fpgadeveloper/ethernetfmc/README.md

# ethernetfmc
Ethernet FMC documentation
==========================

Please read the documentation here:

https://ethernetfmc.com/documentation
