fpgadeveloper/ethernetfmc/docs/source/index.rst

.. Ethernet FMC documentation master file
   You can adapt this file completely to your liking, but it should at least
   contain the root `toctree` directive.

Ethernet FMC Documentation
==========================

Guides
------

* `Getting a license for the Xilinx Tri-mode Ethernet MAC <http://ethernetfmc.com/getting-a-license-for-the-xilinx-tri-mode-ethernet-mac/>`_
* `Using the 1.8V version with the ZedBoard <http://ethernetfmc.com/using-the-1-8v-version-with-the-zedboard/>`_
* `RGMII Interface Timing Considerations <http://ethernetfmc.com/rgmii-interface-timing-considerations/>`_
* `Using the Ethernet FMC without a processor <http://ethernetfmc.com/using-ethernet-fmc-without-a-processor/>`_

.. toctree::
   :maxdepth: 2
   :caption: Datasheet

   overview
   pin_configuration
   specifications
   detailed_description
   mechanical_info
   board_revisions

.. toctree::
   :maxdepth: 2
   :caption: User Guide

   getting_started
   programming_guide
   board_setup
   compatiblility
   eeprom_tool
   references
