fpgadeveloper/ethernetfmc/docs/source/references.rst

==========
References
==========

Board Files
===========

Ethernet FMC
------------

Rev-D
^^^^^

#. `Ethernet FMC Rev-D Schematics PDF <http://ethernetfmc.com/downloads/EthFMC_SCH_RevD-1.PDF>`_
#. `Ethernet FMC Rev-D Assembly Drawing PDF <http://ethernetfmc.com/downloads/EthFMC_ASSM_RevD.PDF>`_
#. `Ethernet FMC Rev-D 3D STEP model <http://ethernetfmc.com/downloads/EthernetFMC_RevD_3D.zip>`_

Rev-E
^^^^^

#. `Ethernet FMC Rev-E Schematics PDF <http://ethernetfmc.com/downloads/EthFMC_SCH_RevE-1.PDF>`_
#. `Ethernet FMC Rev-E Assembly Drawing PDF <http://ethernetfmc.com/downloads/EthFMC_ASSM_RevE.PDF>`_
#. `Ethernet FMC Rev-E 3D STEP model <http://ethernetfmc.com/downloads/EthernetFMC_RevE_3D.zip>`_

Rev-F
^^^^^

#. `Ethernet FMC Rev-F Schematics PDF <http://ethernetfmc.com/downloads/EthFMC_SCH_RevF-1.PDF>`_
#. `Ethernet FMC Rev-F Assembly Drawing PDF <http://ethernetfmc.com/downloads/EthFMC_ASSM_RevF.PDF>`_
#. `Ethernet FMC Rev-F 3D STEP model <http://ethernetfmc.com/downloads/EthernetFMC_RevF_3D.zip>`_

Robust Ethernet FMC
-------------------

Rev-C
^^^^^

#. `Robust Ethernet FMC Rev-C Schematics PDF <http://ethernetfmc.com/downloads/RobustEthFMC_SCH_RevC-1.PDF>`_
#. `Robust Ethernet FMC Rev-C Assembly Drawing PDF <http://ethernetfmc.com/downloads/RobustEthFMC_ASSM_RevC.PDF>`_
#. `Robust Ethernet FMC Rev-C 3D STEP model <http://ethernetfmc.com/downloads/RobustEthernetFMC_RevC_3D.zip>`_

Rev-D
^^^^^

#. `Robust Ethernet FMC Rev-D Schematics PDF <http://ethernetfmc.com/downloads/RobustEthFMC_SCH_RevD-1.PDF>`_
#. `Robust Ethernet FMC Rev-D Assembly Drawing PDF <http://ethernetfmc.com/downloads/RobustEthFMC_ASSM_RevD.PDF>`_
#. `Robust Ethernet FMC Rev-D 3D STEP model <http://ethernetfmc.com/downloads/RobustEthernetFMC_RevD_3D.zip>`_

Part Datasheets
===============

Use the links below to access the datasheets of the significant parts on the mezzanine card.

Ethernet FMC
------------

#. `Gigabit Ethernet PHY, 88E1510, Marvell <https://www.marvell.com/content/dam/marvell/en/public-collateral/transceivers/marvell-phys-transceivers-alaska-88e151x-datasheet-2018-02.pdf>`_ (public datasheet) [#f1]_
#. `Quad RJ45 connector with magnetics, JG0-0025NL, Pulse Electronics <http://productfinder.pulseeng.com/products/datasheets/J410.pdf>`_
#. `Quad RJ45 connector with magnetics, LPJG48851AFNL, Link-PP <http://www.link-pp.com/?product/201605079855.html>`_
#. `Crystal 25MHz, 8Z-25.000MAAJ-T, TXC <http://www.txccorp.com/download/products/quartz_crystals/2015TXC_8Z_16.pdf>`_
#. `Low pin count FMC connector, ASP-134604-01, Samtec <http://suddendocs.samtec.com/prints/asp-134604-01.pdf>`_
#. `Precision LVDS Oscillator 125MHz, DSC1123CI2-125.0000, Microchip <http://ww1.microchip.com/downloads/en/DeviceDoc/DSC1103-23-Low-Jitter-Precision-LVDS-Oscillator-DS20005745C.pdf>`_
#. `2Kbit serial I2C EEPROM, M24C02-FDW6TP, Microchip <https://www.st.com/en/memories/m24c02-f.html>`_

Robust Ethernet FMC
-------------------

#. `Gigabit Ethernet PHY, 88E1510, Marvell <https://www.marvell.com/content/dam/marvell/en/public-collateral/transceivers/marvell-phys-transceivers-alaska-88e151x-datasheet-2018-02.pdf>`_ (public datasheet) [#f1]_
#. `Quad RJ45 connector, RJE72-488-1451, Amphenol <https://cdn.amphenol-icc.com/media/wysiwyg/files/drawing/rje724881xxx.pdf>`_
#. `Ethernet magnetics, HX5020FNL, Pulse Electronics <https://productfinder.pulseeng.com/doc_type/WEB301/doc_num/HX5020FNL/doc_part/HX5020FNL.pdf>`_
#. `Crystal 25MHz, 8Z-25.000MAAJ-T, TXC <http://www.txccorp.com/download/products/quartz_crystals/2015TXC_8Z_16.pdf>`_
#. `Low pin count FMC connector, ASP-134604-01, Samtec <http://suddendocs.samtec.com/prints/asp-134604-01.pdf>`_
#. `Precision LVDS Oscillator 125MHz, DSC1123CI2-125.0000, Microchip <http://ww1.microchip.com/downloads/en/DeviceDoc/DSC1103-23-Low-Jitter-Precision-LVDS-Oscillator-DS20005745C.pdf>`_
#. `2Kbit serial I2C EEPROM, M24C02-FDW6TP, Microchip <https://www.st.com/en/memories/m24c02-f.html>`_

Footnotes
---------

.. [#f1] Marvell has a more detailed datasheet that can be obtained by signing an NDA
         with them. To have an NDA setup, please contact your Marvell representative.
