fpgadeveloper/ethernetfmc/docs/source/images/robust-ethernet-fmc-angle.jpg

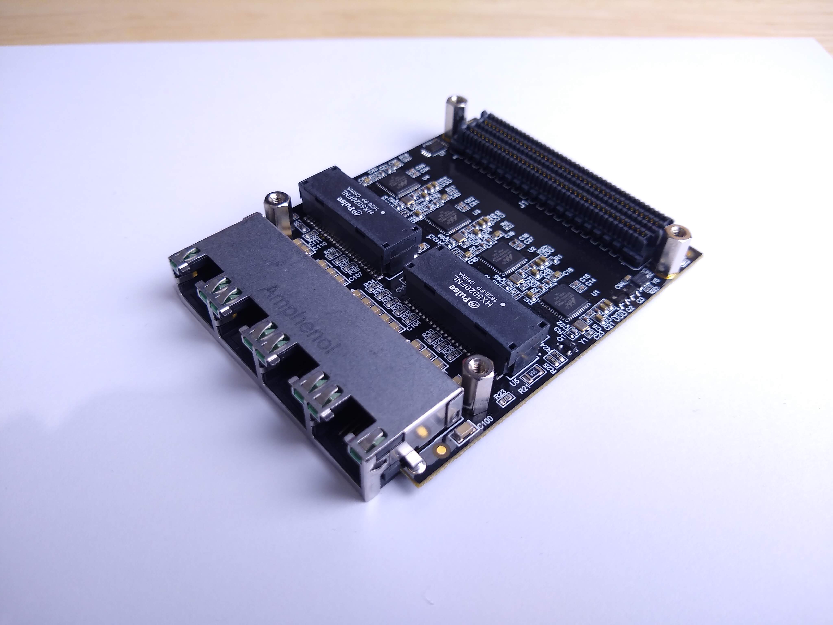
docs/source/images/robust-ethernet-fmc-angle.jpg
