fpgadeveloper/ethernetfmc/(commit log)

2020-06-23 * added links to EEPROM and oscillator datasheets * completed supply voltage specs
2021-05-21 * updated requirements.txt * added mercury pe1-400 to compatible boards * added constraints for mercury board * corrections to notes about rgmii delays with axi eth
    [mercury-pe1-400-fmc0-xu1.xdc, mercury-pe1-400-fmc1-xu1.xdc]
